HXN121988/AI_car/Schematic.pdf

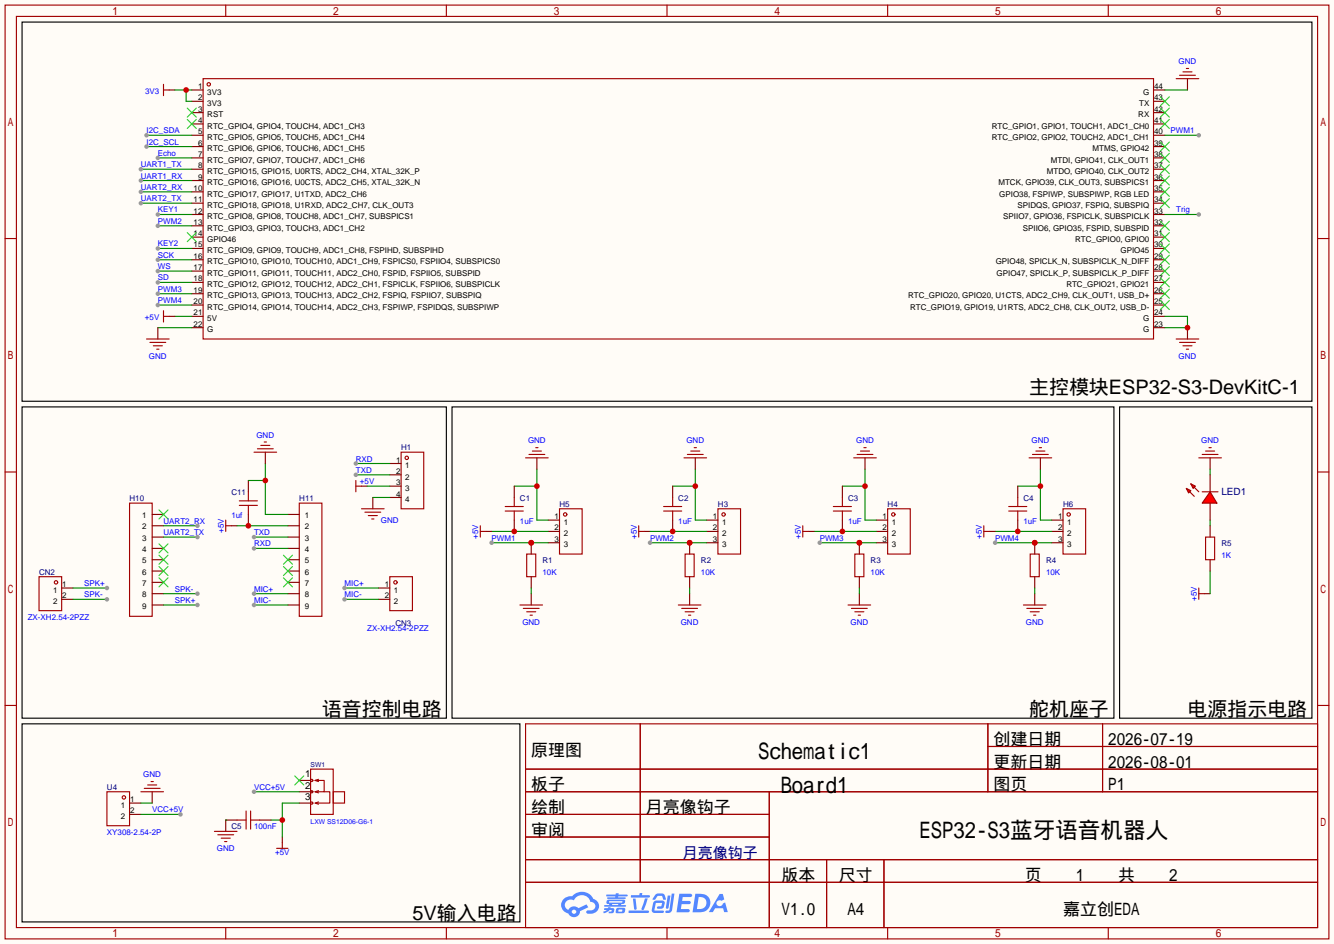
[picture p1: page 1]

MTCK, GPIO39, CLK_OUT3, SUBSPICS1 36
GPIO38, FSPIWP, SUBSPIWP, RGB LED 35
SPIDQS, GPIO37, FSPIQ, SUBSPIQ 34
SPIIO7, GPIO36, FSPICLK, SUBSPICLK 33
SPIIO6, GPIO35, FSPID, SUBSPID 32

原理图 | Schematic1 | 创建日期 | 2026-07-19

更新日期 | 2026-08-01

板子 | Board1 | 图页 | P1
绘制 | 月亮像钩子 | ESP32-S3蓝牙语音机器人
审阅

月亮像钩子

V1.0 | A4 | 嘉立创EDA

OLED显示屏 | 蓝牙座子 | INMP441麦克风

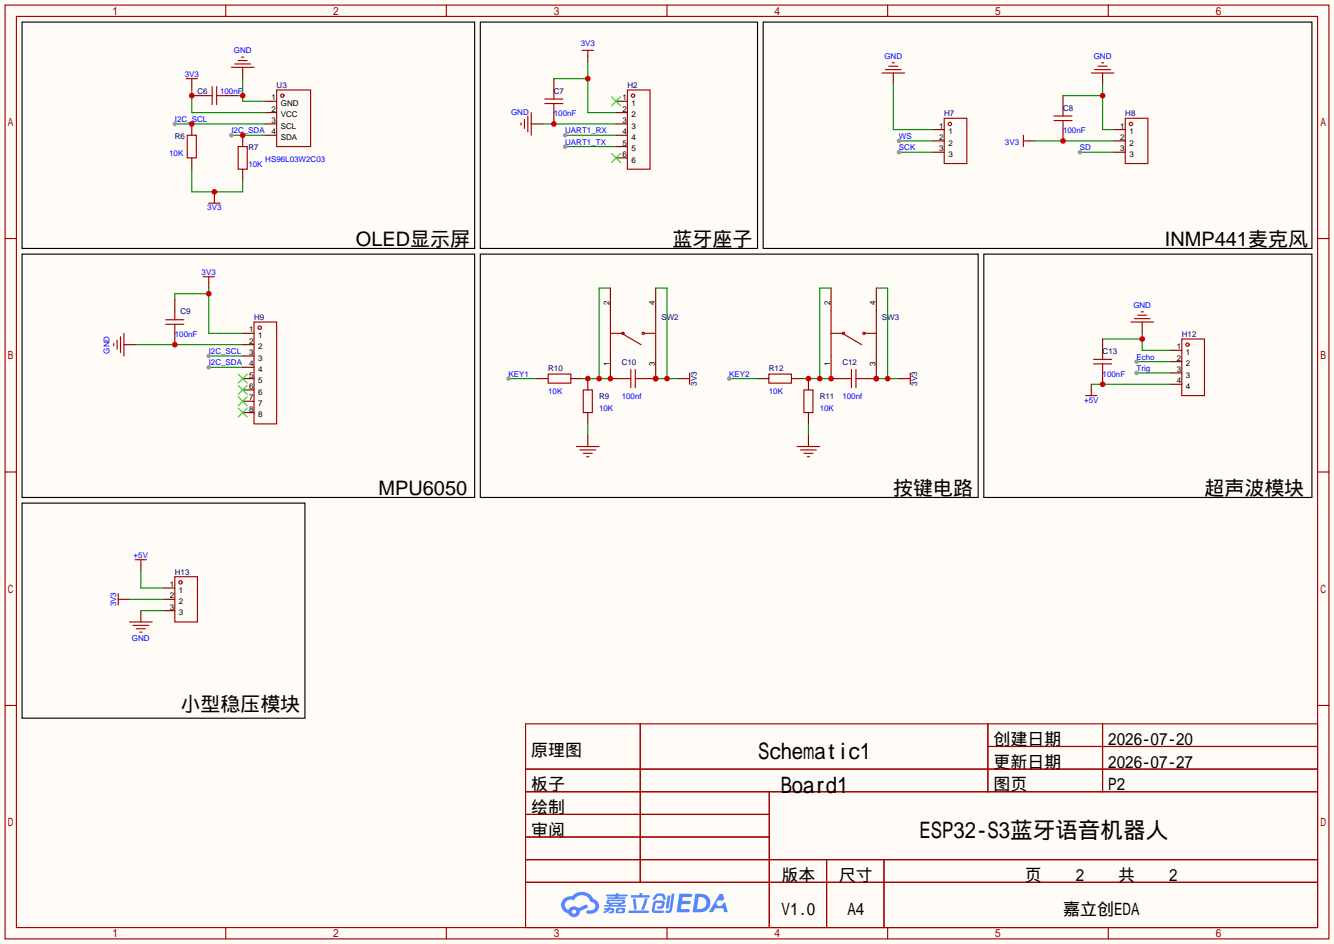
[picture p2: page 2]

原理图 | Schematic1 | 创建日期 | 2026-07-20

更新日期 | 2026-07-27

板子 | Board1 | 图页 | P2
绘制 | | ESP32-S3蓝牙语音机器人
审阅

V1.0 | A4 | 嘉立创EDA
