HXN121988/AI_car/(notices)

Notices in the files:
README.md:
License: MIT
